LHC324/ValveHoll/Document/Clibration01.jpg

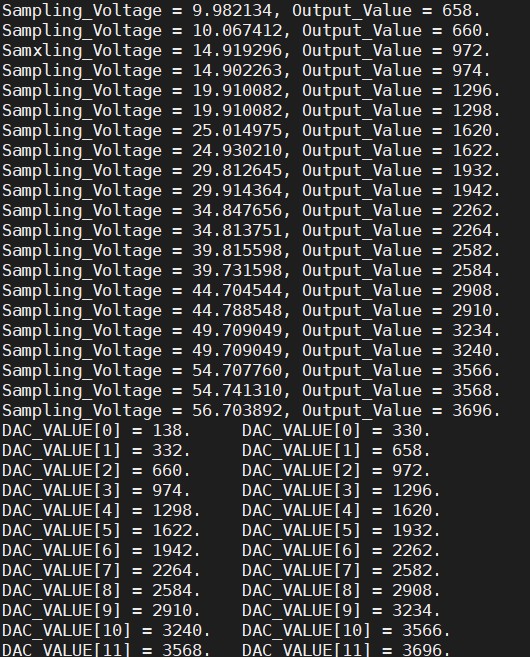
Document/Clibration01.jpg
