LHC324/ValveHoll/Document/Clibration02.jpg

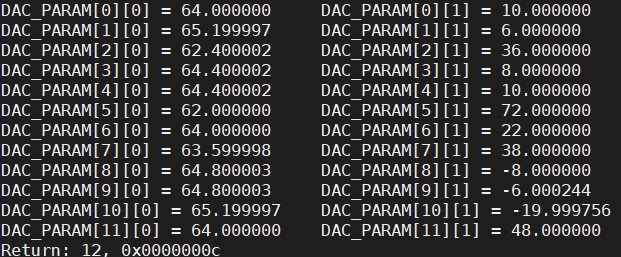
Document/Clibration02.jpg
