LHC324/ValveHoll/Document/拟合曲面.jpg

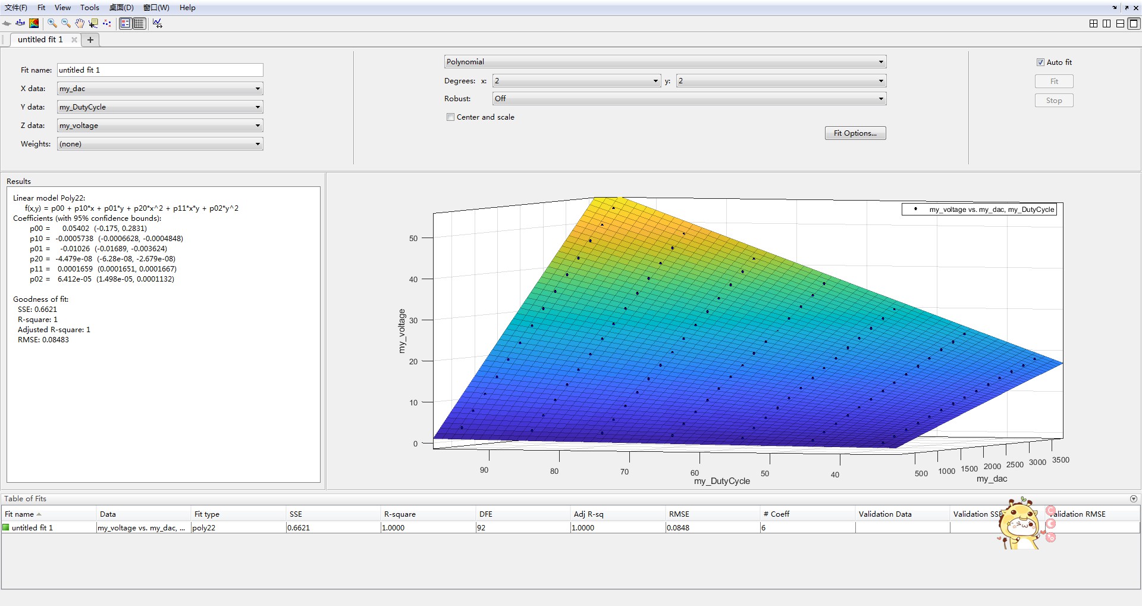
Document/拟合曲面.jpg
