LHC324/ValveHoll/Document/阀厅升降车蓄电池自动充放电控制器.pdf

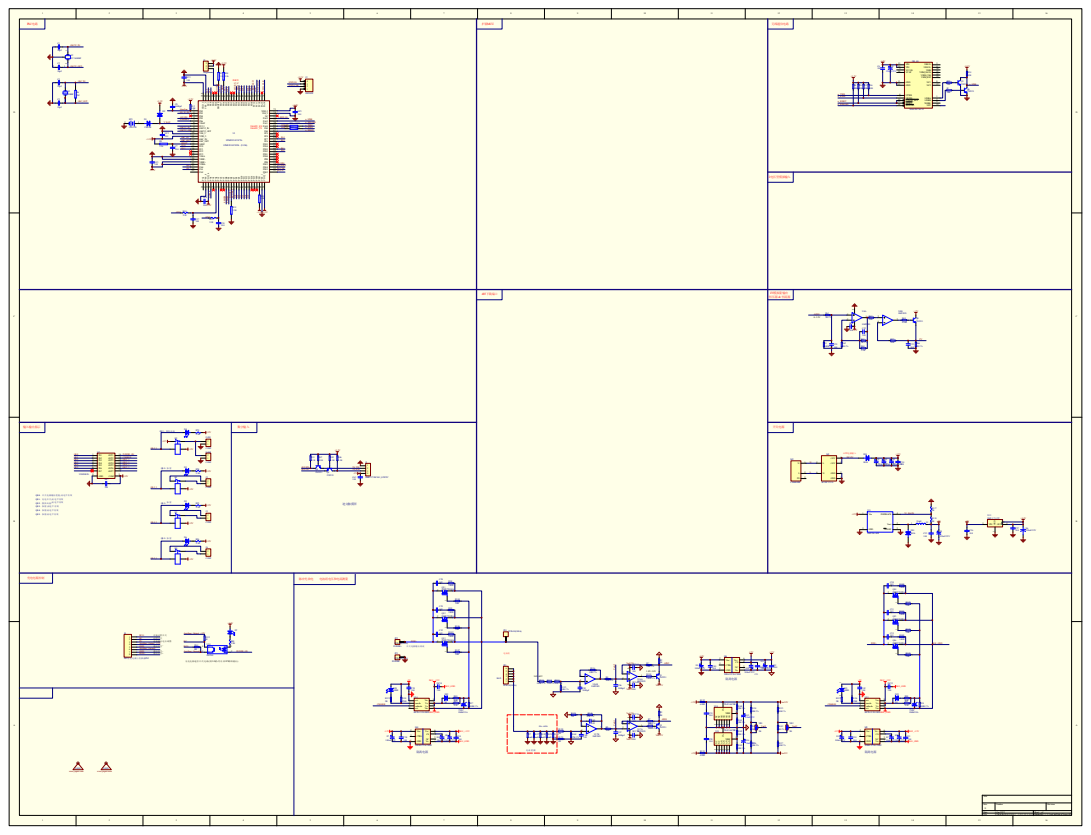
[picture p5: page 1]
