LHC324/ValveHoll/Core/Src/main.c

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
/* Includes ------------------------------------------------------------------*/
#include "main.h"
#include "adc.h"
#include "dac.h"
#include "dma.h"
#include "iwdg.h"
#include "rtc.h"
#include "tim.h"
#include "usart.h"
#include "gpio.h"

/* USER CODE BEGIN Includes */
#include <string.h>
#include "ModbusSlave.h"
#include "mdrtuslave.h"
#if (DEBUGGING == 1U)
#include "shell_port.h"
extern char rx_data;
#endif

/* USER CODE END Includes */


/* USER CODE BEGIN PV */
timer   gTim[TIMER_EVENTS];
/* USER CODE END PV */

void SystemClock_Config(void);
/* USER CODE BEGIN PFP */
void Timer_Task(void);
void Idle_task(void);  
/* USER CODE END PFP */

/**
  * @brief  The application entry point.
  * @retval int
  */
int main(void)
{
  /* MCU Configuration--------------------------------------------------------*/

  /* Reset of all peripherals, Initializes the Flash interface and the Systick. */
  HAL_Init();

  /* Configure the system clock */
  SystemClock_Config();

  /* Initialize all configured peripherals */
  MX_GPIO_Init();
  MX_DMA_Init();
  MX_DAC_Init();
  MX_TIM1_Init();
  MX_USART1_UART_Init();
  MX_USART2_UART_Init();
  MX_RTC_Init();
  MX_ADC1_Init();
//  MX_IWDG_Init();
  /* USER CODE BEGIN 2 */
  /*ADC calibration*/
//  HAL_ADCEx_Calibration_Start(&hadc1);    
	HAL_Delay(3000);
	/*Initialize watchdog*/
#if (!DEBUGGING)
	MX_IWDG_Init();
#endif
	/*Initialize flash*/
	FLASH_Init();
	/*Turn on DMA transmission of ADC*/
	HAL_ADC_Start_DMA(&hadc1, (uint32_t *)AdcDMA_buffer, DMA_SIZE);
	/*Turn on the DAC*/
	HAL_DAC_Start(&hdac, DAC_CHANNEL_1);
	/*Start timer 1*/
	HAL_TIM_Base_Start_IT(&htim1);
	/*Initialize communication parameters*/
	CommunicationInit();
	ModbusInit();
  /*Initialize the shell interface*/
#if (DEBUGGING == 1U)
  HAL_UART_Receive_IT(&huart1, (uint8_t *)&rx_data, 1);
  User_Shell_Init();
#endif
  /* USER CODE END 2 */

  /* Infinite loop */
  /* USER CODE BEGIN WHILE */
    while (1)
    {
    /* USER CODE END WHILE */

    /* USER CODE BEGIN 3 */
		  Timer_Task();
		  Idle_task();
      /*ModBusdata processing*/
      mdRTU_Handler();
#if (!DEBUGGING)
		  /*feed a dog*/
      // HAL_IWDG_Refresh(&hiwdg);
#endif
    }

  /* USER CODE END 3 */
}

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
/* USER CODE BEGIN 4 */
/*time slice task*/
void Timer_Task(void)
{
	for(uint8_t i = 0; i < g_TimerNumbers; i++)
	{
		if(gTim[i].execute_flag)  
		{
			gTim[i].event();
			gTim[i].execute_flag = false;
		}
	}
}

/*
 *idle task
 */
void Idle_task(void)
{  
#if (!DEBUGGING)
  /*Serial port 1 receives data*/
	if(rx1ReciveOver_Flag == true)  
	{
  /*4G module communication is not enabled when debug interface is enabled*/

    mdhandler->portRTUPushString(mdhandler, receive1_buff, rx1Conut);
		rx1ReciveOver_Flag = false;	
		memset(receive1_buff, 0, rx1Conut);
    rx1Conut = 0; 
		HAL_UART_Receive_DMA(&huart1, receive1_buff, BUFFER_SIZE);
	}
#endif	
	if(rx2ReciveOver_Flag == true)
	{ 
		DWIN_ReciveNew(receive2_buff, rx2Conut);
		DWIN_Poll();
		rx2ReciveOver_Flag = false;	
		memset(receive2_buff, 0, rx2Conut);
		rx2Conut = 0; 
		HAL_UART_Receive_DMA(&huart2, receive2_buff, BUFFER_SIZE);
	}
}
/* USER CODE END 4 */
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
