LHC324/ValveHoll/ValveHoll-Changer.ioc

Mcu.UserName=STM32F103VETx
PA0-WKUP.GPIO_Label=POWER_ON
PA0-WKUP.Signal=GPIO_Output
PA1.GPIO_Label=CHARGING_SWITCH
PA1.Signal=GPIO_Output
PA10.Signal=USART1_RX
PA13.Signal=SYS_JTMS-SWDIO
PA14.Signal=SYS_JTCK-SWCLK
PA4.Signal=COMP_DAC1_group
PA6.Signal=ADCx_IN6
PA7.Signal=ADCx_IN7
PA9.Signal=USART1_TX
PB4.GPIO_Label=DISCHARGING_SWITCH
PB4.Signal=GPIO_Output
PC14-OSC32_IN.Signal=RCC_OSC32_IN
PC15-OSC32_OUT.Signal=RCC_OSC32_OUT
PD0.GPIO_Label=FANS_POWER
PD0.Signal=GPIO_Output
PD1.GPIO_Label=CHIP_POWER
PD1.Signal=GPIO_Output
PD5.Signal=USART2_TX
PD6.Signal=USART2_RX
