LHC324/ValveHoll/Core/Inc/main.h

#define DEBUGGING	0
#define TIMER_EVENTS 50U	/*Number of software timers*/
#define POWER_ON_Pin GPIO_PIN_0
#define POWER_ON_GPIO_Port GPIOA
#define CHARGING_SWITCH_Pin GPIO_PIN_1
#define CHARGING_SWITCH_GPIO_Port GPIOA
#define FANS_POWER_Pin GPIO_PIN_0
#define FANS_POWER_GPIO_Port GPIOD
#define CHIP_POWER_Pin GPIO_PIN_1
#define CHIP_POWER_GPIO_Port GPIOD
#define DISCHARGING_SWITCH_Pin GPIO_PIN_4
#define DISCHARGING_SWITCH_GPIO_Port GPIOB
