LHC324/ValveHoll/Core/Src/rtc.c

/**
  ******************************************************************************
  * @file    rtc.c
  * @brief   This file provides code for the configuration
  *          of the RTC instances.
  ******************************************************************************
  * @attention
  *
  * <h2><center>&copy; Copyright (c) 2022 STMicroelectronics.
  * All rights reserved.</center></h2>
  *
  * This software component is licensed by ST under BSD 3-Clause license,
  * the "License"; You may not use this file except in compliance with the
  * License. You may obtain a copy of the License at:
  *                        opensource.org/licenses/BSD-3-Clause
  *
  ******************************************************************************
  */

/* Includes ------------------------------------------------------------------*/
#include "rtc.h"

/* USER CODE BEGIN 0 */

#include "usart.h"

RTC_DateTypeDef sdatestructure = {0};
RTC_TimeTypeDef stimestructure = {0};

/* USER CODE END 0 */

RTC_HandleTypeDef hrtc;

/* RTC init function */
void MX_RTC_Init(void)
{

  RTC_TimeTypeDef sTime = {0};
  RTC_DateTypeDef DateToUpdate = {0};

  /** Initialize RTC Only
  */
  hrtc.Instance = RTC;
  hrtc.Init.AsynchPrediv = 32767;
  hrtc.Init.OutPut = RTC_OUTPUTSOURCE_ALARM;
  if (HAL_RTC_Init(&hrtc) != HAL_OK)
  {
    Error_Handler();
  }

  /* USER CODE BEGIN Check_RTC_BKUP */
    if(HAL_RTCEx_BKUPRead(&hrtc, RTC_BKP_DR1) != 0x5050)
    {
        uint32_t stramp;

        sTime.Hours = 30;
        sTime.Minutes = 13;
        sTime.Seconds = 30;

        DateToUpdate.WeekDay = 5;
        DateToUpdate.Month = 12;
        DateToUpdate.Date = 25;
        DateToUpdate.Year = 21;

        stramp = time2Stamp(DateToUpdate, sTime);
        SetRtcCount(stramp);

        HAL_RTCEx_BKUPWrite(&hrtc, RTC_BKP_DR1, 0x5050);
    }

    myRtc_Get_DateTime(&sdatestructure, &stimestructure);  //更新时间

    return;

  /* USER CODE END Check_RTC_BKUP */

  /** Initialize RTC and set the Time and Date
  */
  sTime.Hours = 12;
  sTime.Minutes = 20;
  sTime.Seconds = 20;

  if (HAL_RTC_SetTime(&hrtc, &sTime, RTC_FORMAT_BIN) != HAL_OK)
  {
    Error_Handler();
  }
  DateToUpdate.WeekDay = RTC_WEEKDAY_MONDAY;
  DateToUpdate.Month = RTC_MONTH_JANUARY;
  DateToUpdate.Date = 1;
  DateToUpdate.Year = 20;

  if (HAL_RTC_SetDate(&hrtc, &DateToUpdate, RTC_FORMAT_BIN) != HAL_OK)
  {
    Error_Handler();
  }
}

void HAL_RTC_MspInit(RTC_HandleTypeDef* rtcHandle)
{

  if(rtcHandle->Instance==RTC)
  {
    HAL_PWR_EnableBkUpAccess();
    /* Enable BKP CLK enable for backup registers */
    __HAL_RCC_BKP_CLK_ENABLE();
    /* RTC clock enable */
    __HAL_RCC_RTC_ENABLE();
  }
}

void HAL_RTC_MspDeInit(RTC_HandleTypeDef* rtcHandle)
{

  if(rtcHandle->Instance==RTC)
  {
    /* Peripheral clock disable */
    __HAL_RCC_RTC_DISABLE();
  }
}

/* USER CODE BEGIN 1 */

/*
 *  北京时间转时间戳
 */
uint32_t time2Stamp(RTC_DateTypeDef date, RTC_TimeTypeDef time)
{
    uint32_t result;
    uint16_t monDays[12] = {0, 31, 59, 90, 120, 151, 181, 212, 243, 273, 304, 334};
    uint16_t Year = date.Year + 2000;
    result = (Year - 1970) * 365 * 24 * 3600 + (monDays[date.Month - 1] + date.Date - 1) * 24 * 3600 + (time.Hours - 8) * 3600 + time.Minutes * 60 + time.Seconds;

    result += (date.Month > 2 && (Year % 4 == 0) && (Year % 100 != 0 || Year % 400 == 0)) * 24 * 3600;	//闰月

    Year -= 1970;
    result += (Year / 4 - Year / 100 + Year / 400) * 24 * 3600;		//闰年
    return result;
}


/*
 *    时间戳转换为时间
 *   �???: 时区北京为东8区，如果�???8区则-8
 */
void Stamp2time(RTC_DateTypeDef* pdate, RTC_TimeTypeDef* ptime, uint32_t Timestamp, int timezone)
{

    uint16_t year = 1970;
    uint32_t Counter = 0, CounterTemp;
    uint8_t Month[12] = {31, 28, 31, 30, 31, 30, 31, 31, 30, 31, 30, 31};
    uint8_t i;

    Timestamp = Timestamp + timezone * 3600; //修正时区

    while(Counter <= Timestamp)
    {
        CounterTemp = Counter;
        Counter += 31536000;

        if(IsLeapYear(year))
        {
            Counter += 86400;
        }

        year++;
    }

    pdate->Year = year - 1 - 2000;
    Month[1] = (IsLeapYear(year - 1) ? 29 : 28);
    Counter = Timestamp - CounterTemp;
    CounterTemp = Counter / 86400;
    Counter -= CounterTemp * 86400;
    ptime->Hours = Counter / 3600;
    ptime->Minutes = Counter % 3600 / 60;
    ptime->Seconds = Counter % 60;

    for(i = 0; i < 12; i++)
    {
        if(CounterTemp < Month[i])                                        //不能包含相等的情况，相等会导致最后一天切换到下一个月第一天时
        {

            pdate->Month = i + 1;                                                  // 月份不加1，日期溢出（如：出现32号）
            pdate->Date = CounterTemp + 1;
            break;
        }

        CounterTemp -= Month[i];
    }

    getWEEK(pdate);
}
/*
 * 判断闰年平年
 */
uint8_t IsLeapYear(uint16_t year)
{
    if(((year) % 4 == 0 && (year) % 100 != 0) || (year) % 400 == 0)
        return 1;

    return 0;
}

/*
 *  函数功能:根据具体日期得到星期
 *  吉姆拉尔森公�???  week=(date+2*month+3*(month+1)/5+year+year/4-y/100+y/400)%7
 *  �??? : 把一�??? 二月看成是上�???年的13 14�???    ,    得到结果 0 -- 6
 */
void getWEEK(RTC_DateTypeDef* time)
{
    uint16_t YY = 0;
    uint8_t MM = 0;

    if(time->Month == 1 || time->Month == 2)
    {
        MM = time->Month + 12;
        YY = time->Year - 1 + 2000;
    }
    else
    {
        MM = time->Month;
        YY = time->Year + 2000;
    }

    time->WeekDay = ( (time->Date + 2 * MM + 3 * (MM + 1) / 5 + YY + YY / 4 - YY / 100 + YY / 400) % 7 ) + 1;
}                     //(29 + 16 + 5 + 2018 +2018/4 - 2018/100 + 2018/400)%7
//(29 + 16 + 5 + 18 +18/4 - 18/100 + 18/400)%7

/*
 *     获取当前时间
 */
void myRtc_Get_DateTime(RTC_DateTypeDef* pdate, RTC_TimeTypeDef* ptime)
{
    uint32_t timecount = 0;
    timecount = RTC->CNTH;
    timecount <<= 16;
    timecount += RTC->CNTL;

    Stamp2time(pdate, ptime, timecount, 8);
}

/*
 * 设置时钟计数器�??
 */
void SetRtcCount(uint32_t tramp)
{
    //设置时钟
    RCC->APB1ENR |= 1 << 28; //使能电源时钟
    RCC->APB1ENR |= 1 << 27; //使能备份时钟
    PWR->CR |= 1 << 8; //取消备份区写保护
    //上面三步是必须的!
    RTC->CRL |= 1 << 4; //允许配置
    RTC->CNTL = tramp & 0xffff;
    RTC->CNTH = tramp >> 16;
    RTC->CRL &= ~(1 << 4); //配置更新

    while(!(RTC->CRL & (1 << 5)));
}

/* USER CODE END 1 */

/************************ (C) COPYRIGHT STMicroelectronics *****END OF FILE****/
