LHC324/ValveHoll/Core/Inc/usart.h

/**
  ******************************************************************************
  * @file    usart.h
  * @brief   This file contains all the function prototypes for
  *          the usart.c file
  ******************************************************************************
  * @attention
  *
  * <h2><center>&copy; Copyright (c) 2022 STMicroelectronics.
  * All rights reserved.</center></h2>
  *
  * This software component is licensed by ST under BSD 3-Clause license,
  * the "License"; You may not use this file except in compliance with the
  * License. You may obtain a copy of the License at:
  *                        opensource.org/licenses/BSD-3-Clause
  *
  ******************************************************************************
  */
/* Define to prevent recursive inclusion -------------------------------------*/
#ifndef __USART_H__
#define __USART_H__

#ifdef __cplusplus
extern "C" {
#endif

/* Includes ------------------------------------------------------------------*/
#include "main.h"

/* USER CODE BEGIN Includes */
#define BUFFER_SIZE	256U

 extern bool rx1ReciveOver_Flag;
 extern uint16_t rx1Conut;
 extern uint8_t receive1_buff[BUFFER_SIZE];
 extern bool rx2ReciveOver_Flag;
 extern uint16_t rx2Conut;
 extern uint8_t receive2_buff[BUFFER_SIZE];

/* USER CODE END Includes */

extern UART_HandleTypeDef huart1;
extern UART_HandleTypeDef huart2;

void MX_USART1_UART_Init(void);
void MX_USART2_UART_Init(void);

/* USER CODE BEGIN Prototypes */

static void USART1_IdleCallback(uint8_t* dat,uint16_t Length);
static void USART2_IdleCallback(uint8_t* dat,uint16_t Length);
extern void Usart1_Printf(const char *format,...);
/* USER CODE END Prototypes */

#ifdef __cplusplus
}
#endif

#endif /* __USART_H__ */

/************************ (C) COPYRIGHT STMicroelectronics *****END OF FILE****/
