LHC324/ValveHoll/(commit log)

2022-01-05 基础功能全部正确
    [DGUSII变量分配表.xls, ValveHoll-Changer Debug.cfg]
2022-01-11 修改了屏幕数据显示错误问题
2022-01-22 增加了ADC自动校准
2022-01-24 修复了flash读写错误
2022-01-25 修复了部分问题
    [阀厅充电器测试项目.xls]
2022-01-25 完善了README
